Davydero/Proyecto-DiploIoT/RaspberryConnections.PNG

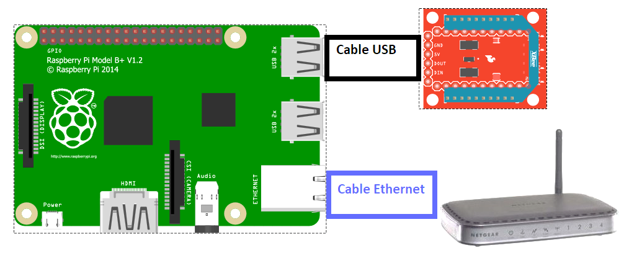
RaspberryConnections.PNG
