Davydero/Proyecto-DiploIoT/GeneralDescription.PNG

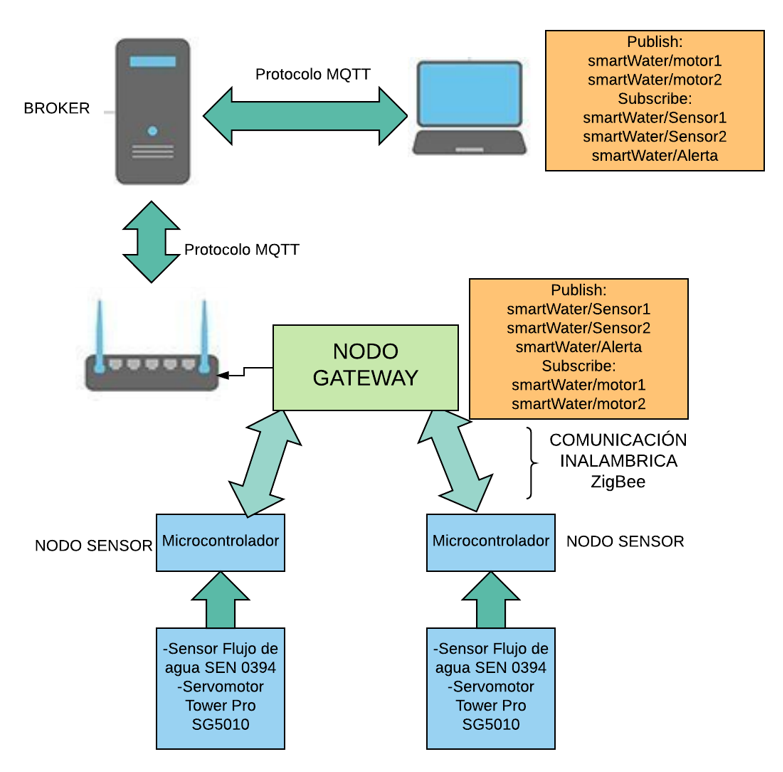
GeneralDescription.PNG
