Davydero/Proyecto-DiploIoT/WebInterface1.PNG

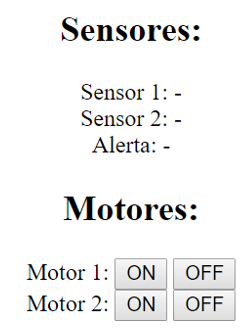
WebInterface1.PNG
