Davydero/Proyecto-DiploIoT/WebInterface2.PNG

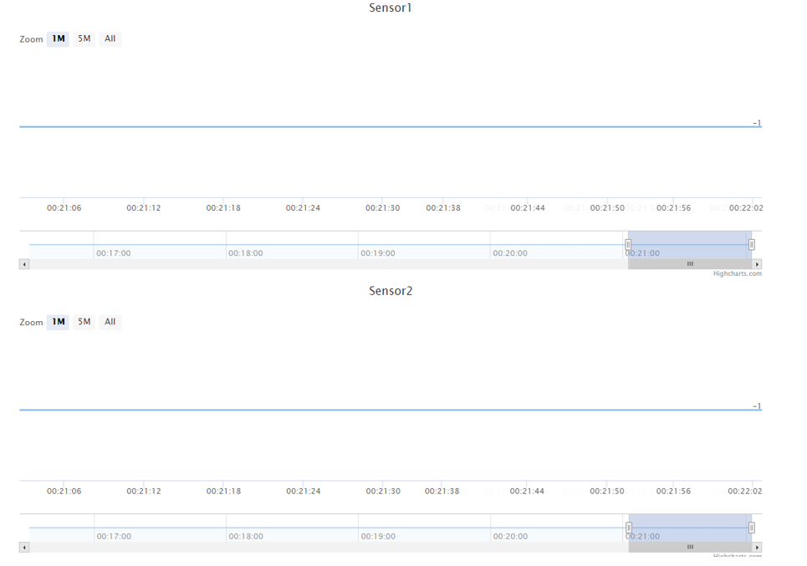
WebInterface2.PNG
