Davydero/Proyecto-DiploIoT/(commit log)

2023-05-08 Arduino script added
2023-05-08 Raspberry pi file added
